saman-fuyal/stm32-datalogger/stm32-datalogger/firmware/fatfs/README.md

FatFs R0.16 (patch 2) by ChaN, http://elm-chan.org/fsw/ff/
ff.c, ff.h, diskio.h copied unchanged from github.com/STMicroelectronics/stm32_mw_fatfs.
ffconf.h changed: code page 437, FF_FS_TINY 1, no LFN, no mkfs, no exFAT.
License: see top of ff.c and LICENSE_ST.md. Glue to the SD driver is ../src/diskio.c.
