saman-fuyal/stm32-datalogger/stm32-datalogger/docs/captures/boot_message.png

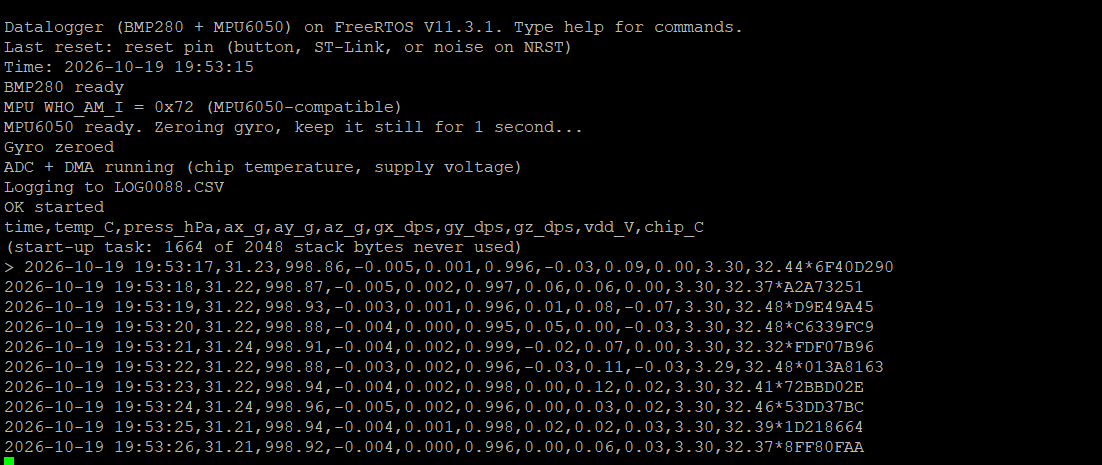
stm32-datalogger/docs/captures/boot_message.png
