saman-fuyal/stm32-datalogger/stm32-datalogger/docs/mpu6050_calibration_values.md

# MPU6050 calibration

From bringup/08 (6 positions). Using the 2nd round in firmware/src/config.h.

after 1st round of calb,

    #define ACC_OFF_X 651
    #define ACC_OFF_Y 60
    #define ACC_OFF_Z 954
    #define ACC_SCALE_X 16365
    #define ACC_SCALE_Y 16380
    #define ACC_SCALE_Z 16483

after 2nd round of calb,

    #define ACC_OFF_X 653
    #define ACC_OFF_Y 46
    #define ACC_OFF_Z 925
    #define ACC_SCALE_X 16375
    #define ACC_SCALE_Y 16356
    #define ACC_SCALE_Z 16510
