saman-fuyal/stm32-datalogger/stm32-datalogger/results/LOG0123.CSV

time | temp_C | press_hPa | ax_g | ay_g | az_g | gx_dps | gy_dps | gz_dps | vdd_V | chip_C
2026-10-20 01:16:46 | 28.33 | 998.63 | -0.010 | 0.001 | 1.001 | 0.00 | 0.14 | -0.03 | 3.22 | 29.69*0DC35899
2026-10-20 01:16:47 | 28.33 | 998.68 | -0.004 | 0.000 | 0.992 | 0.10 | 0.10 | 0.05 | 3.22 | 29.58*D417297E
2026-10-20 01:16:48 | 28.32 | 998.67 | -0.005 | 0.002 | 0.998 | 0.11 | 0.12 | 0.03 | 3.22 | 29.62*A45C907C
2026-10-20 01:16:49 | 28.33 | 998.63 | -0.006 | 0.001 | 0.999 | 0.08 | 0.11 | -0.03 | 3.22 | 29.67*7F6E6270
2026-10-20 01:16:50 | 28.33 | 998.61 | -0.009 | 0.000 | 0.998 | 0.07 | 0.11 | 0.06 | 3.22 | 29.60*6ECF71F7
2026-10-20 01:16:51 | 28.33 | 998.63 | -0.010 | 0.000 | 0.996 | 0.00 | 0.06 | 0.00 | 3.22 | 29.72*CCEC076F
2026-10-20 01:16:52 | 28.34 | 998.64 | -0.005 | 0.001 | 0.995 | 0.00 | 0.08 | -0.03 | 3.22 | 29.55*6C56FEB2
2026-10-20 01:16:53 | 28.33 | 998.63 | -0.007 | 0.000 | 0.997 | 0.05 | 0.12 | 0.02 | 3.22 | 29.65*51E5ED06
2026-10-20 01:16:54 | 28.34 | 998.65 | -0.005 | 0.000 | 0.998 | 0.09 | 0.12 | 0.00 | 3.22 | 29.72*EF2DB21E
2026-10-20 01:16:55 | 28.33 | 998.63 | -0.006 | 0.001 | 0.994 | 0.00 | 0.22 | -0.02 | 3.22 | 29.65*4929A6E3
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
