saman-fuyal/stm32-datalogger/stm32-datalogger/firmware/startup/startup_stm32f103.c

/*
 * Startup code for the STM32F103C8 (written in C, no assembly).
 * The vector table lists the address of every interrupt handler. Handlers that
 * the program does not define fall back to Default_Handler, which stops in a loop.
 * Reset_Handler copies initialised variables to RAM, clears the rest, then calls main().
 *
 * STM32CubeIDE users: do NOT add this file. CubeIDE already gives the project its own
 * startup_stm32f103c8tx.s with the same handler names.
 */
#include <stdint.h>

extern uint32_t _sidata, _sdata, _edata, _sbss, _ebss, _estack;
extern int main(void);

void Reset_Handler(void);
void Default_Handler(void);

#define WEAK_ALIAS __attribute__((weak, alias("Default_Handler")))

void NMI_Handler(void)          WEAK_ALIAS;
void HardFault_Handler(void)    WEAK_ALIAS;
void MemManage_Handler(void)    WEAK_ALIAS;
void BusFault_Handler(void)     WEAK_ALIAS;
void UsageFault_Handler(void)   WEAK_ALIAS;
void SVC_Handler(void)          WEAK_ALIAS;
void DebugMon_Handler(void)     WEAK_ALIAS;
void PendSV_Handler(void)       WEAK_ALIAS;
void SysTick_Handler(void)      WEAK_ALIAS;

void WWDG_IRQHandler(void)            WEAK_ALIAS;
void PVD_IRQHandler(void)             WEAK_ALIAS;
void TAMPER_IRQHandler(void)          WEAK_ALIAS;
void RTC_IRQHandler(void)             WEAK_ALIAS;
void FLASH_IRQHandler(void)           WEAK_ALIAS;
void RCC_IRQHandler(void)             WEAK_ALIAS;
void EXTI0_IRQHandler(void)           WEAK_ALIAS;
void EXTI1_IRQHandler(void)           WEAK_ALIAS;
void EXTI2_IRQHandler(void)           WEAK_ALIAS;
void EXTI3_IRQHandler(void)           WEAK_ALIAS;
void EXTI4_IRQHandler(void)           WEAK_ALIAS;
void DMA1_Channel1_IRQHandler(void)   WEAK_ALIAS;
void DMA1_Channel2_IRQHandler(void)   WEAK_ALIAS;
void DMA1_Channel3_IRQHandler(void)   WEAK_ALIAS;
void DMA1_Channel4_IRQHandler(void)   WEAK_ALIAS;
void DMA1_Channel5_IRQHandler(void)   WEAK_ALIAS;
void DMA1_Channel6_IRQHandler(void)   WEAK_ALIAS;
void DMA1_Channel7_IRQHandler(void)   WEAK_ALIAS;
void ADC1_2_IRQHandler(void)          WEAK_ALIAS;
void USB_HP_CAN1_TX_IRQHandler(void)  WEAK_ALIAS;
void USB_LP_CAN1_RX0_IRQHandler(void) WEAK_ALIAS;
void CAN1_RX1_IRQHandler(void)        WEAK_ALIAS;
void CAN1_SCE_IRQHandler(void)        WEAK_ALIAS;
void EXTI9_5_IRQHandler(void)         WEAK_ALIAS;
void TIM1_BRK_IRQHandler(void)        WEAK_ALIAS;
void TIM1_UP_IRQHandler(void)         WEAK_ALIAS;
void TIM1_TRG_COM_IRQHandler(void)    WEAK_ALIAS;
void TIM1_CC_IRQHandler(void)         WEAK_ALIAS;
void TIM2_IRQHandler(void)            WEAK_ALIAS;
void TIM3_IRQHandler(void)            WEAK_ALIAS;
void TIM4_IRQHandler(void)            WEAK_ALIAS;
void I2C1_EV_IRQHandler(void)         WEAK_ALIAS;
void I2C1_ER_IRQHandler(void)         WEAK_ALIAS;
void I2C2_EV_IRQHandler(void)         WEAK_ALIAS;
void I2C2_ER_IRQHandler(void)         WEAK_ALIAS;
void SPI1_IRQHandler(void)            WEAK_ALIAS;
void SPI2_IRQHandler(void)            WEAK_ALIAS;
void USART1_IRQHandler(void)          WEAK_ALIAS;
void USART2_IRQHandler(void)          WEAK_ALIAS;
void USART3_IRQHandler(void)          WEAK_ALIAS;
void EXTI15_10_IRQHandler(void)       WEAK_ALIAS;
void RTC_Alarm_IRQHandler(void)       WEAK_ALIAS;
void USBWakeUp_IRQHandler(void)       WEAK_ALIAS;

typedef void (*vector_t)(void);

__attribute__((section(".isr_vector"), used))
const vector_t vector_table[16 + 43] = {
    (vector_t)&_estack,            /* initial stack pointer */
    Reset_Handler,
    NMI_Handler,
    HardFault_Handler,
    MemManage_Handler,
    BusFault_Handler,
    UsageFault_Handler,
    0, 0, 0, 0,                    /* reserved */
    SVC_Handler,
    DebugMon_Handler,
    0,                             /* reserved */
    PendSV_Handler,
    SysTick_Handler,
    /* peripheral interrupts, number 0 .. 42 */
    WWDG_IRQHandler,               /*  0 */
    PVD_IRQHandler,
    TAMPER_IRQHandler,
    RTC_IRQHandler,
    FLASH_IRQHandler,
    RCC_IRQHandler,                /*  5 */
    EXTI0_IRQHandler,
    EXTI1_IRQHandler,
    EXTI2_IRQHandler,
    EXTI3_IRQHandler,
    EXTI4_IRQHandler,              /* 10 */
    DMA1_Channel1_IRQHandler,
    DMA1_Channel2_IRQHandler,
    DMA1_Channel3_IRQHandler,
    DMA1_Channel4_IRQHandler,
    DMA1_Channel5_IRQHandler,      /* 15 */
    DMA1_Channel6_IRQHandler,
    DMA1_Channel7_IRQHandler,
    ADC1_2_IRQHandler,
    USB_HP_CAN1_TX_IRQHandler,
    USB_LP_CAN1_RX0_IRQHandler,    /* 20 */
    CAN1_RX1_IRQHandler,
    CAN1_SCE_IRQHandler,
    EXTI9_5_IRQHandler,
    TIM1_BRK_IRQHandler,
    TIM1_UP_IRQHandler,            /* 25 */
    TIM1_TRG_COM_IRQHandler,
    TIM1_CC_IRQHandler,
    TIM2_IRQHandler,
    TIM3_IRQHandler,
    TIM4_IRQHandler,               /* 30 */
    I2C1_EV_IRQHandler,
    I2C1_ER_IRQHandler,
    I2C2_EV_IRQHandler,
    I2C2_ER_IRQHandler,
    SPI1_IRQHandler,               /* 35 */
    SPI2_IRQHandler,
    USART1_IRQHandler,             /* 37 */
    USART2_IRQHandler,
    USART3_IRQHandler,
    EXTI15_10_IRQHandler,          /* 40 */
    RTC_Alarm_IRQHandler,          /* 41 */
    USBWakeUp_IRQHandler,          /* 42 */
};

void Reset_Handler(void)
{
    uint32_t *src = &_sidata;
    uint32_t *dst = &_sdata;

    while (dst < &_edata) {        /* copy initialised variables from flash to RAM */
        *dst++ = *src++;
    }
    for (dst = &_sbss; dst < &_ebss; ) {   /* variables without a start value become 0 */
        *dst++ = 0;
    }
    (void)main();
    while (1) { }
}

void Default_Handler(void)          /* an interrupt with no handler fired: stop here */
{
    while (1) { }
}
