saman-fuyal/stm32-datalogger/(commit log)

2026-10-31 STM32 data logger: firmware, tools, hardware, results, report
    [LOG0123.CSV]
2026-10-31 Report: honest power comparison, STM32 peers in Table I, new title
